burakaydinmu/camur-kabul-bunkeri-on-tasarim/README.md

# Çamur kabul bunkeri — ön tasarım

Baretli Kafa YouTube kanalının "AutoCAD ve Yapay Zeka" bölümünde, Claude'un açık AutoCAD'e bağlanarak hazırladığı örnek ön tasarım: 20 m³'lük yer altı çamur kabul bunkeri, şaftsız helezon konveyörler, deşarj çukuru ve DN50 PN16 flanşlı basma hattı, iki kanatlı sürgülü kapak.

**Ön tasarımdır; imalata ve uygulamaya esas değildir.** Statik, elektrik ve iş güvenliği projeleri ayrıca hazırlanmalıdır.

## Dosyalar
- `bunker.dwg` — AutoCAD çizimi: 6 A1 pafta ve 3B katı model
- `paftalar-pdf/` — paftaların PDF çıktıları (CD-BNK-01 … 06)
- `Montaj-Kilavuzu.pdf` — malzeme listesi ve adım adım montaj kılavuzu (kaynaklar son sayfada)
- `bunker_3B_*.png` — 3B görüntüler (06 no.lu paftada çizime bağlıdır, `bunker.dwg` ile aynı klasörde durmalıdır)
