burakaydinmu/camur-kabul-bunkeri-on-tasarim/paftalar-pdf/CD-BNK-06_Malzeme-listesi-ve-3B.pdf

Firma / yasal sahip BARETLİ KAFA | Proje CLAUDE DENEMESİ Çamur kabul bunkeri — ön tasarım
Çizen Claude | Çizim adı MALZEME LİSTESİ VE 3B GÖRÜNÜŞ Bütün sistem — malzeme listesi, 3B model görüntüleri
Kontrol | —
Onay — | Belge türü Ön tasarım çizimi | Ölçek — | Boyut A1
Tarih 2026-10-07 | Çizim no CD-BNK-06 | Rev. A | Pafta 6 / 6

# 3B MODEL — güneybatıdan bakış (kapak açık)

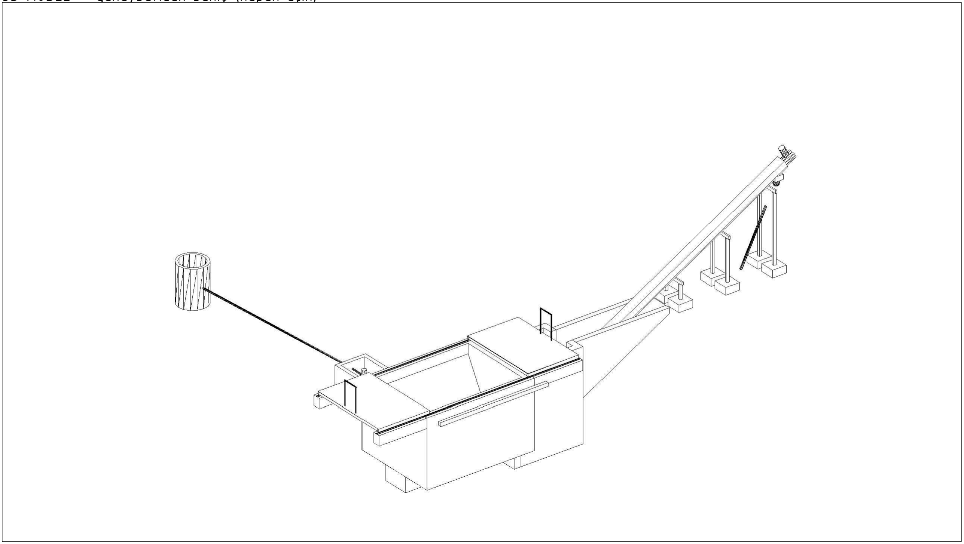
[picture p1: figure]

# 3B MODEL — güneydoğudan bakış (kapak açık)

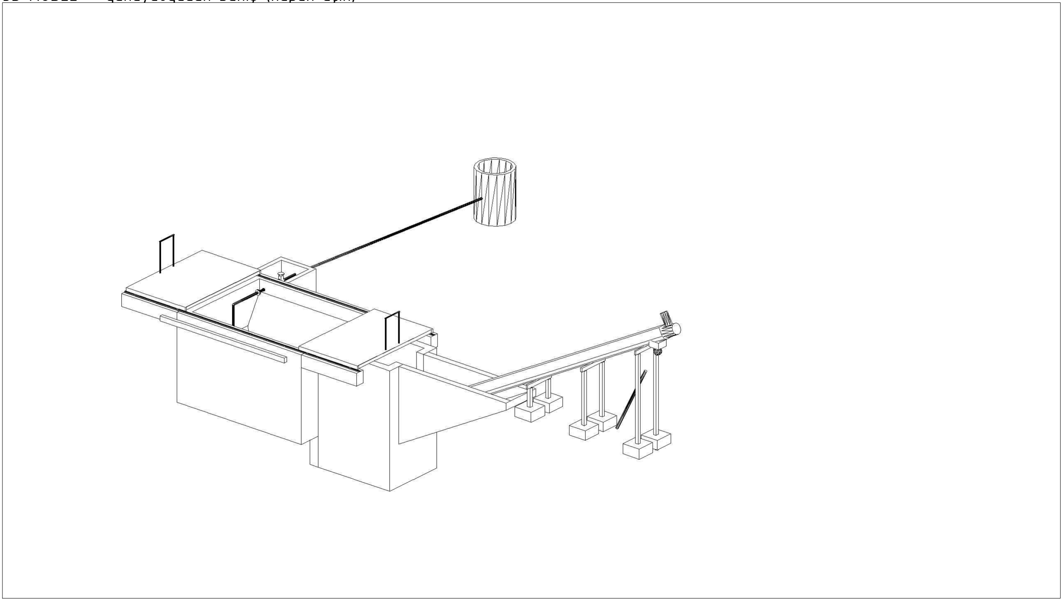
[picture p2: figure]

3B katı model, model uzayında X = 33 600…53 000, Y = 9 000…24 500 bölgesindedir (orijin: 40 000, 12 000; Z = kot). Katmanlar: CL-3D-BETON (mevcut), CL-3D-BETON-EK (öneri), CL-3D-KONVEYOR, CL-3D-CELIK, CL-3D-BORU, CL-3D-KAPAK. Görüntüler gizli çizgili çizdirmedir; modelde spiral, cıvata ve küçük parçalar gösterilmemiştir.

## MALZEME LİSTESİ — BÜTÜN SİSTEM

No | Tanım | Özellik / standart | Miktar | Pafta
A | KONVEYÖR SİSTEMİ
A1 | K1 yatay şaftsız helezon (çıkarıcı) | Ø400, oluk iç 432, L = 4250 (3300 açık + 950 kapalı), 1.4301, UHMW-PE astar 12 mm | 1 takım | 02
A2 | K1 tahrik grubu | Mile geçme redüktörlü motor 2,2 kW + frekans konvertörü + tork kolu (emin değilim) | 1 | 02
A3 | K2 eğimli şaftsız helezon | Ø355, oluk iç 381, L = 13 536, eğim 28,9°, 1.4301, astar 12 mm, cıvatalı kapak | 1 takım | 02
A4 | K2 tahrik grubu | Redüktörlü motor 4,0 kW (çekme tipi) + frekans konvertörü (emin değilim) | 1 | 02
A5 | K1 çıkış / K2 giriş ağzı | 400×400, flanşlı, contalı, 1.4301 | 1 | 02
A6 | K2 döküş ağzı | 350×350, flanş kotu +3,00 | 1 | 02
A7 | K2 destek ayağı (yer üstü) | 2 × SHS 100×100×4 + UPN 120 + L 50×50×5; taban plakası 250×250×12, 4×M16 | 3 | 02
A8 | K2 ayağı / sehpa (çukur ve kanal içi) | Çelik sehpa, dübelli | 3 | 02
A9 | K1 duvar konsolu | Çelik konsol + dübel | 1 | 02
A10 | Çukur ve kanal kapakları | Baklavalı sac 5/7, sökülebilir; 700×700 erişim kapağı + merdiven | 1 takım | 02
A11 | Acil durdurma, dönüş bekçisi, pano | EN 618; kapsam dışı — ayrıca projelendirilecek | 1 takım | —
B | DEŞARJ ÇUKURU VE BASMA HATTI
B1 | Dalgıç pompa | Grundfos Unilift AP35B.50.08.A1V, Rp 2, 1×230 V, 0,71 kW (P2) | 1 | 03
B2 | Dişli flanş + nipel | DN50 PN16, EN 1092-1 Tip 13, 1.4301 | 1 | 03
B3–B5, B8 | Boru makaraları S1–S4 + gömülü boru | Ø60,3×2,0, 1.4301, EN 10217-7; toplam ≈ 13 m; 1 dirsek 90° r = 76 | 4 parça | 03
B6 | Toplu çekvalf | DN50, L = 200, EN 12050-4 (AVK 53/35) | 1 | 03
B7 | Sürgülü vana | DN50 PN10/16, L = 150, EN 1074-2 (AVK 06/80) | 1 | 03
B9 | Flanş | EN 1092-1 Tip 01, DN50 PN16, 1.4301 | 7 | 03
B10 / B11 | Conta / cıvata takımı | EN 1514-1 IBC 61×107×2 / M16×65 A2-70 + somun + 2 pul | 6 / 24 | 03
B12 / B13 | Duvar geçiş contası / boru kelepçesi | Hauff HSD100 (karot Ø100) / DN50 mesafeli, A2 | 3 / 3 | 03
B14 | Deflektör sacı + boru yakası | 1.4301, t = 5, yamuk 600/1975 × 1400, alt 150 mm delikli | 1 | 03
B15 | Vana odası kapağı | Baklavalı sac 5/7, 2 parça, köşebent çerçeve | 1 | 03
C | SÜRGÜLÜ KAPAK
C1 | Kanat 1 (komple) | 2170 × 3360; RHS 120×60×4 + RHS 100×50×3 + sac 4/6; galvanizli; ≈ 490 kg | 1 | 05
C2 | Kanat 2 (komple) | Kanat 1 ile ayna simetrik, bini laması yok; ≈ 480 kg | 1 | 05
C3 | Ray | Mil Ø20 + lama 80×10, S235JR, galvanizli, L = 8700 | 2 | 04
C4 | Tekerlek | Ø140 × 32, yuvarlak oluklu, 2 rulmanlı, 550 kg/teker (IBFM 363 veya eşdeğeri) | 8 | 04
C5 | Ray durdurucusu | Plaka 100×60×10 + lastik tampon | 4 | 04
C6 | Germe mandalı / kilitleme sürgüsü | A2 / Ø16 (ürün seçimi imalatçıda — emin değilim) | 4 / 4 | 04
C7 | Ankraj | M12×110, a = 400, şaşırtmalı | 44 | 04
C8 | Sac cıvatası + perçin somunu | M8×25 havşa başlı, A2 | 176 | 05
D | İNŞAAT İŞLERİ — ÖNERİ (statik proje gerekir)
D1 | Aktarma çukuru | İç 2400 × 1600, taban −3,45, duvar 250, döşeme 300 | 1 | 01, 02
D2 | Konveyör kanalı | Net genişlik 900, yatay boy 4240, duvar 200 | 1 | 01, 02
D3 | Deşarj çukuru | İç 600 × 700 × 700, duvar ve taban 250 | 1 | 03
D4 | Vana odası | İç 1000 × 1100 × 700, duvar ve taban 150 | 1 | 03
D5 | Çıkış duvarı geçiş boşluğu | 560 × 560, su tutucu bant + büzülmesiz harç | 1 | 02
D6 | Ray şerit temeli | 300 × 400; batıda 2 × 2050, doğuda 2 × 2050 | 4 | 04
D7 | Destek ayağı temeli | 600 × 600 × 300 | 7 | 02
D8 | Oluk içi eğim betonu (45° pah) | ≈ 0,54 m³, ikinci döküm | 1 | 02
D9 | Karot delik | Ø100 (bunker duvarı, vana odası, rögar) | 3 | 03
D10 | Tekerlek takozu + seyyar korkuluk | Kamyon tarafı / döküm yapılmayan kenarlar (EN ISO 14122-3, h ≥ 1100) | 1 takım | 01
