burakaydinmu/camur-kabul-bunkeri-on-tasarim/bunker_3B_guneybati.png

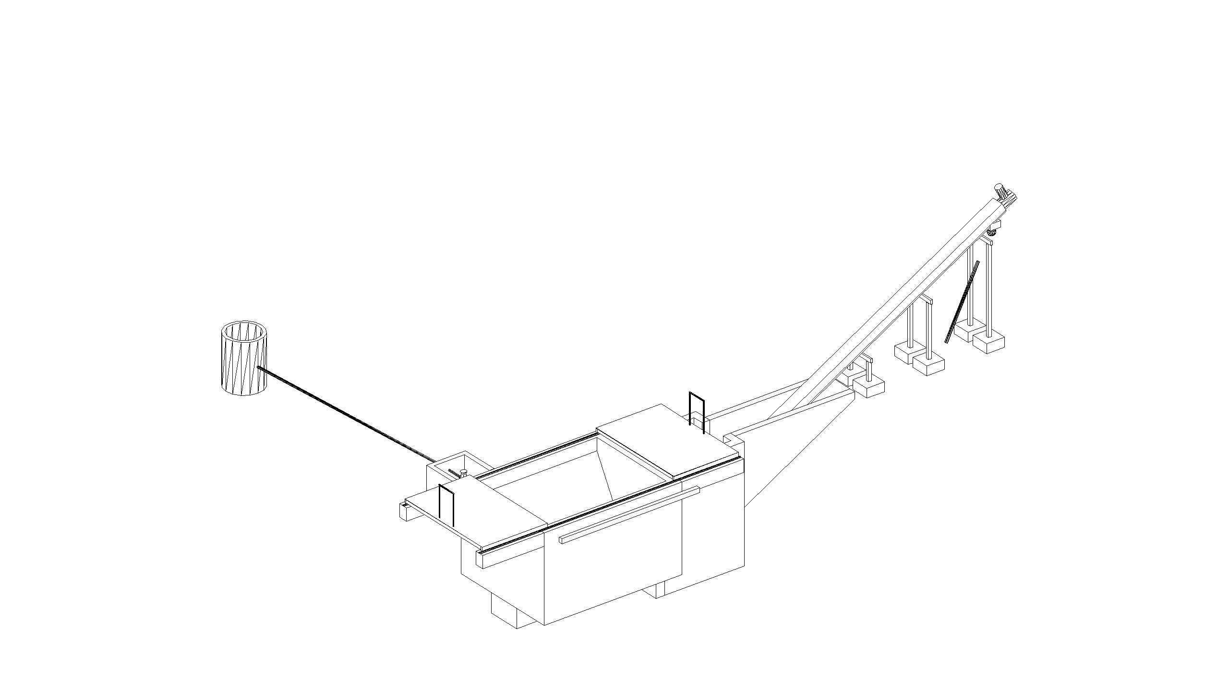
bunker_3B_guneybati.png
