burakaydinmu/camur-kabul-bunkeri-on-tasarim/bunker_3B_guneydogu.png

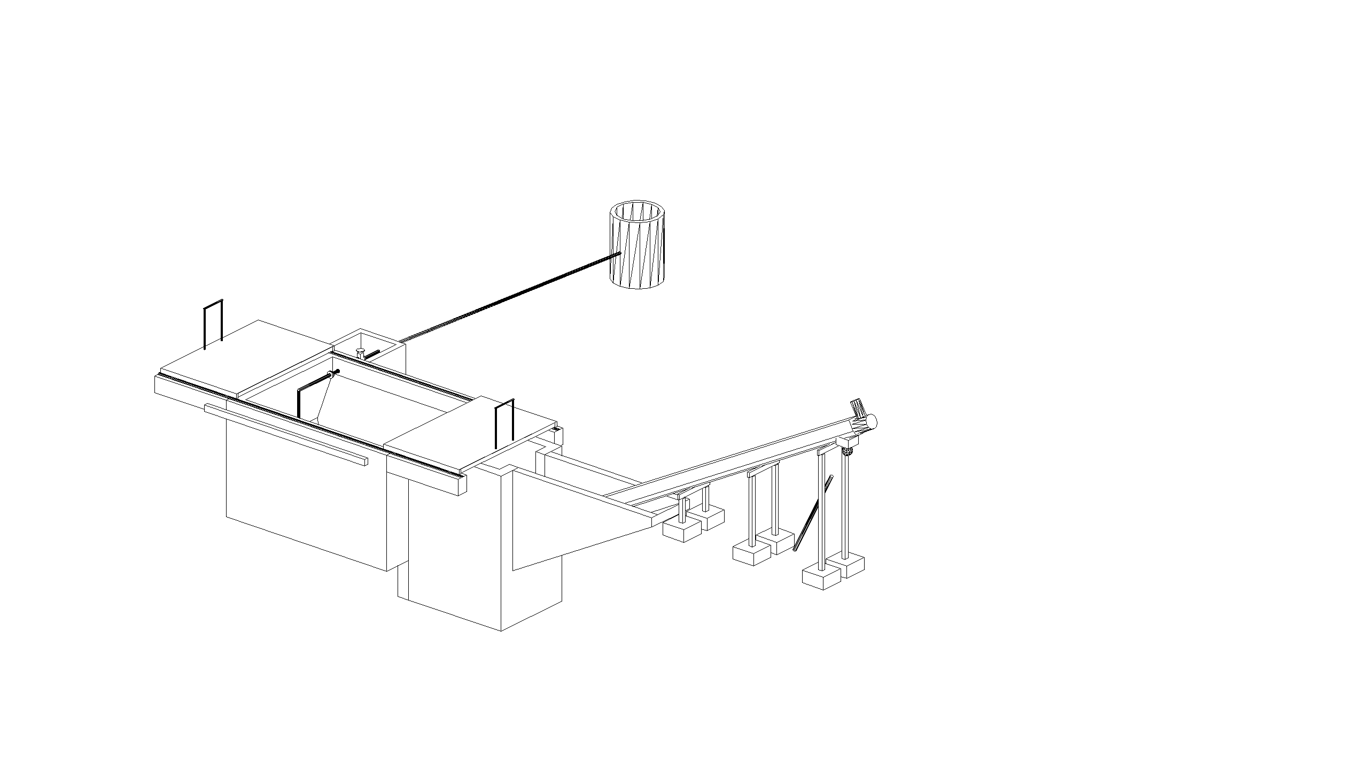
bunker_3B_guneydogu.png
