burakaydinmu/camur-kabul-bunkeri-on-tasarim/(list of files, cad)

Other CAD files:
bunker.dwg
