burakaydinmu/camur-kabul-bunkeri-on-tasarim/paftalar-pdf/CD-BNK-03_Desarj-cukuru-ve-basma-hatti.pdf

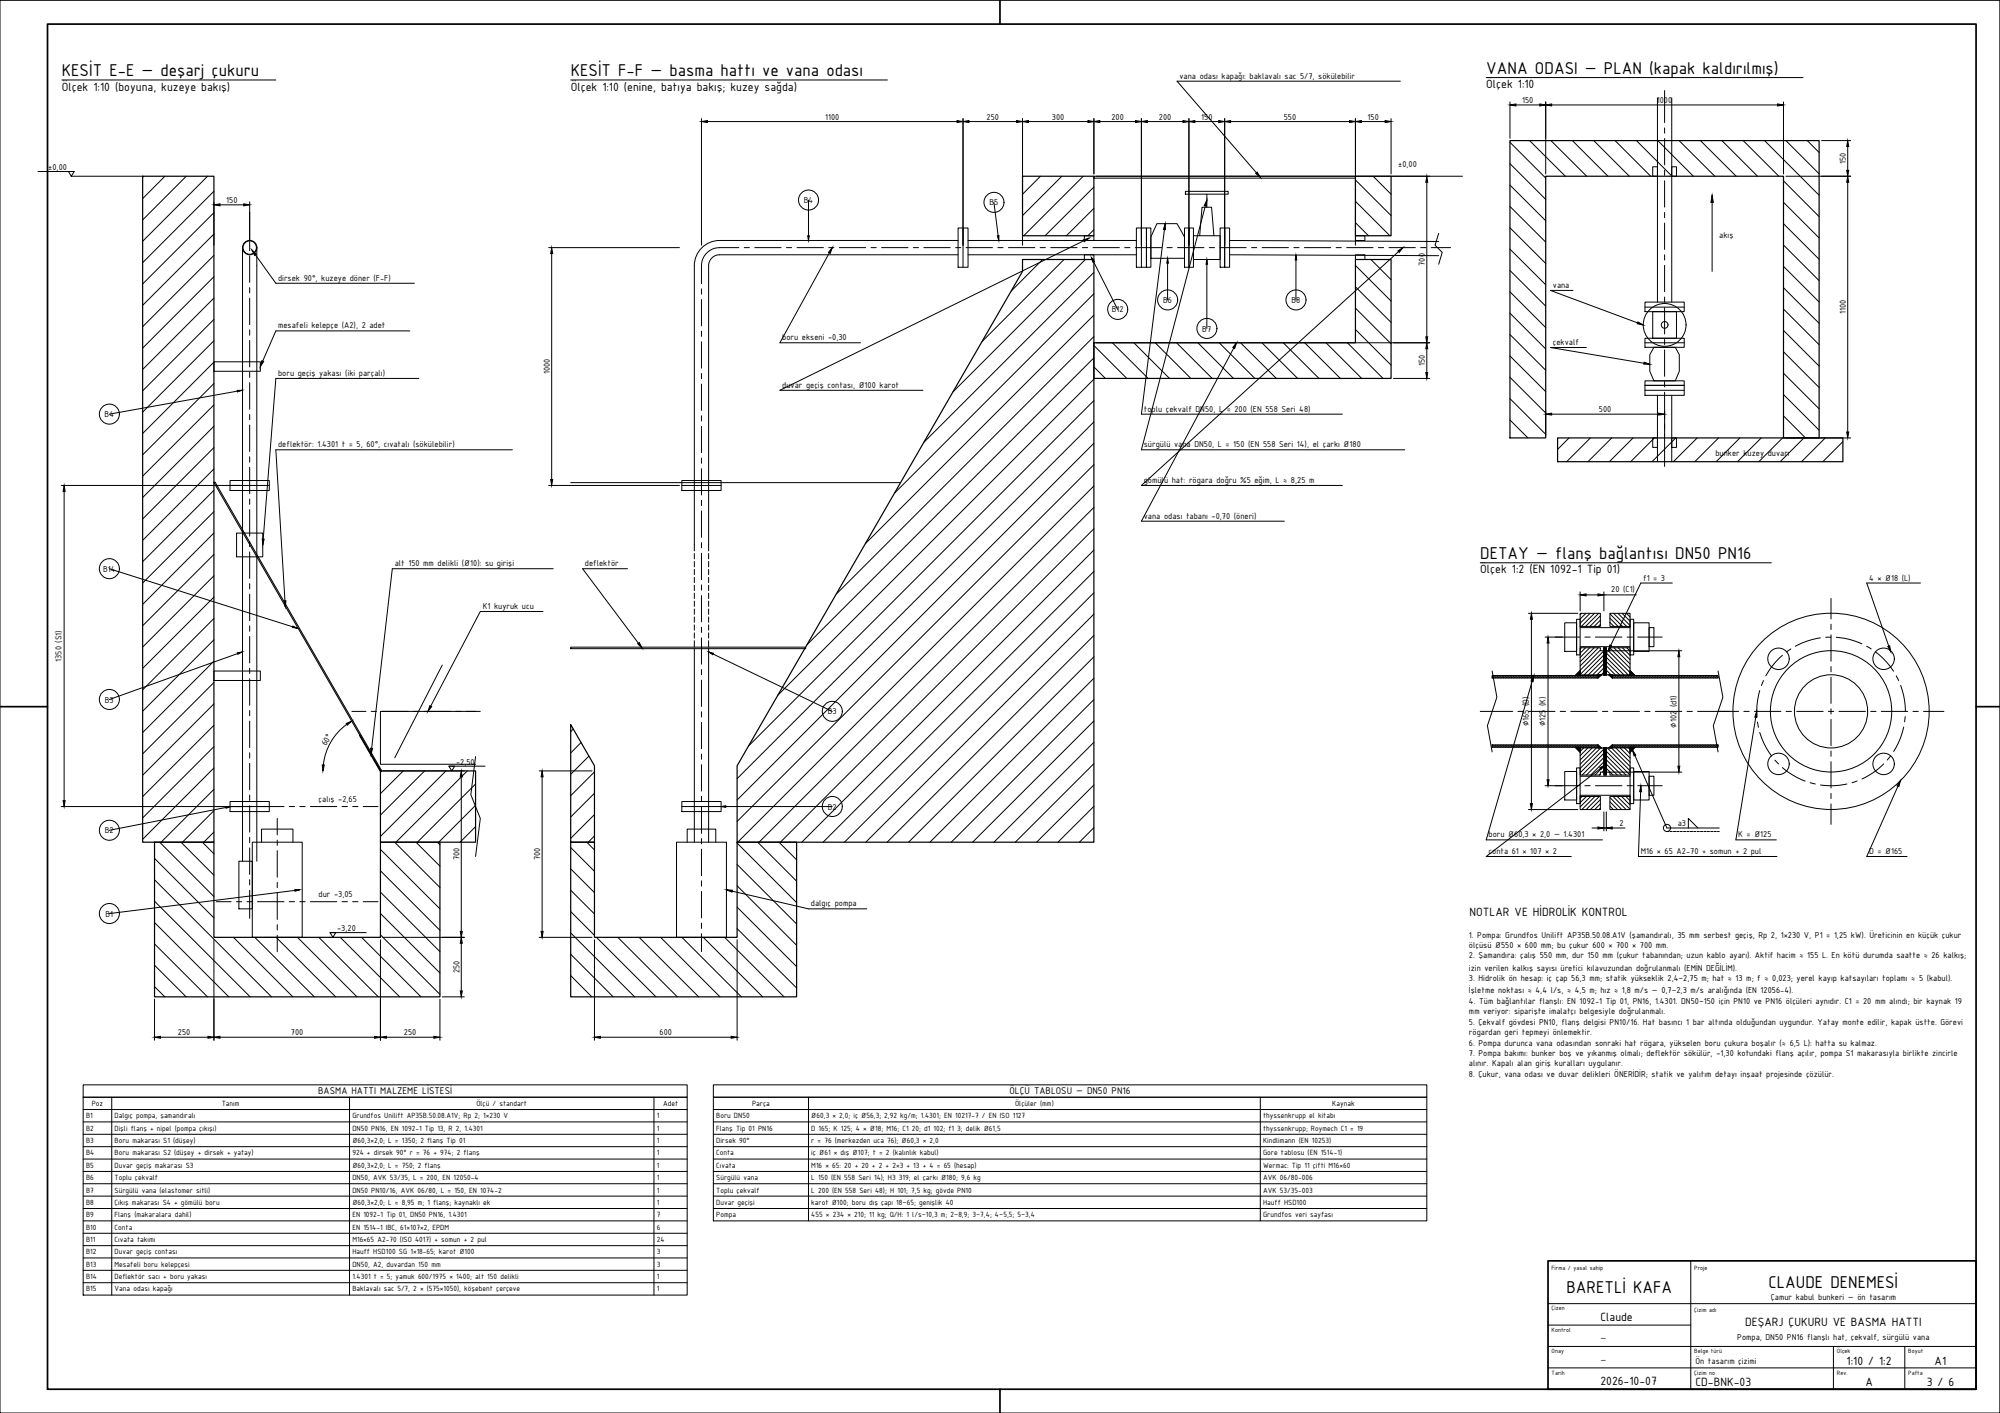
[picture p11: page 1]
çalış −2,65; dur −3,05; K1 kuyruk ucu; boru ekseni −0,30; dalgıç pompa; Ölçek 1:2 (EN 1092-1 Tip 01) ∅165 (D); boru Ø60,3 × 2,0 — 1.4301; conta 61 × 107 × 2; M16 × 65 A2-70 + somun + 2 pul; Poz; Tanım; Ölçü / standart; Adet; Dalgıç pompa, şamandıralı; Grundfos Unilift AP35B.50.08.A1V; Rp 2; 1×230 V; Dişli flanş + nipel (pompa çıkışı); DN50 PN16, EN 1092-1 Tip 13, R 2, 1.4301; Boru makarası S1 (düşey); Ø60,3×2,0; L = 1350; 2 flanş Tip 01; Boru makarası S2 (düşey + dirsek + yatay)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

KESİT E-E — deşarj çukuru
Ölçek 1:10 (boyuna, kuzeye bakış)

KESİT F-F — basma hattı ve vana odası
Ölçek 1:10 (enine, batıya bakış; kuzey sağda)

VANA ODASI — PLAN (kapak kaldırılmış) Ölçek 1:10

vana odası kapağı: baklavalı sac 5/7, sökülebilir

dirsek 90°, kuzeye döner (F-F)

mesafeli kelepçe (A2), 2 adet

boru geçiş yakası (iki parçalı)

duvar geçiş contası, Ø100 karot

toplu çekvalf DN50, L = 200 (EN 558 Seri 48)

deflektör: 1.4301 t = 5, 60°, cıvatalı (sökülebilir)

sürgülü vana DN50, L = 150 (EN 558 Seri 14), el çarkı Ø180

bunker kuzey duvarı

gömülü hat: rögara doğru %5 eğim, L ≈ 8,25 m

vana odası tabanı −0,70 (öneri)

DETAY — flanş bağlantısı DN50 PN16

alt 150 mm delikli (Ø10): su girişi

NOTLAR VE HİDROLİK KONTROL

1. Pompa: Grundfos Unilift AP35B.50.08.A1V (şamandıralı, 35 mm serbest geçiş, Rp 2, 1×230 V, P1 = 1,25 kW). Üreticinin en küçük çukur
ölçüsü Ø550 × 600 mm; bu çukur 600 × 700 × 700 mm.
2. Şamandıra: çalış 550 mm, dur 150 mm (çukur tabanından; uzun kablo ayarı). Aktif hacim ≈ 155 L. En kötü durumda saatte ≈ 26 kalkış;
izin verilen kalkış sayısı üretici kılavuzundan doğrulanmalı (EMİN DEĞİLİM).
3. Hidrolik ön hesap: iç çap 56,3 mm; statik yükseklik 2,4–2,75 m; hat ≈ 13 m; f ≈ 0,023; yerel kayıp katsayıları toplamı ≈ 5 (kabul).
İşletme noktası ≈ 4,4 l/s, ≈ 4,5 m; hız ≈ 1,8 m/s — 0,7–2,3 m/s aralığında (EN 12056-4).
4. Tüm bağlantılar flanşlı: EN 1092-1 Tip 01, PN16, 1.4301. DN50–150 için PN10 ve PN16 ölçüleri aynıdır. C1 = 20 mm alındı; bir kaynak 19
mm veriyor: siparişte imalatçı belgesiyle doğrulanmalı.
5. Çekvalf gövdesi PN10, flanş delgisi PN10/16. Hat basıncı 1 bar altında olduğundan uygundur. Yatay monte edilir, kapak üstte. Görevi
rögardan geri tepmeyi önlemektir.
6. Pompa durunca vana odasından sonraki hat rögara, yükselen boru çukura boşalır (≈ 6,5 L): hatta su kalmaz.
7. Pompa bakımı: bunker boş ve yıkanmış olmalı; deflektör sökülür, −1,30 kotundaki flanş açılır, pompa S1 makarasıyla birlikte zincirle
alınır. Kapalı alan giriş kuralları uygulanır.
8. Çukur, vana odası ve duvar delikleri ÖNERİDİR; statik ve yalıtım detayı inşaat projesinde çözülür.

BASMA HATTI MALZEME LİSTESİ

B10 | Conta | EN 1514-1 IBC, 61×107×2, EPDM | 6
B11 | Cıvata takımı | M16×65 A2-70 (ISO 4017) + somun + 2 pul | 24

B12 | Duvar geçiş contası | Hauff HSD100 SG 1×18-65; karot Ø100 | 3
B13 | Mesafeli boru kelepçesi | DN50, A2, duvardan 150 mm | 3
B14 | Deflektör sacı + boru yakası | 1.4301 t = 5; yamuk 600/1975 × 1400; alt 150 delikli | 1
B15 | Vana odası kapağı | Baklavalı sac 5/7, 2 × (575×1050), köşebent çerçeve | 1

Firma / yasal sahip BARETLİ KAFA | Proje CLAUDE DENEMESİ Çamur kabul bunkeri — ön tasarım

Çizen Claude | Çizim adı DEŞARJ ÇUKURU VE BASMA HATTI Pompa, DN50 PN16 flanşlı hat, çekvalf, sürgülü vana

Onay — | Belge türü Ön tasarım çizimi | Ölçek 1:10 / 1:2 | Boyut A1

Tarih 2026-10-07 | Çizim no CD-BNK-03 | Rev. A | Pafta 3 / 6
