burakaydinmu/camur-kabul-bunkeri-on-tasarim/paftalar-pdf/CD-BNK-04_Kapak-genel.pdf

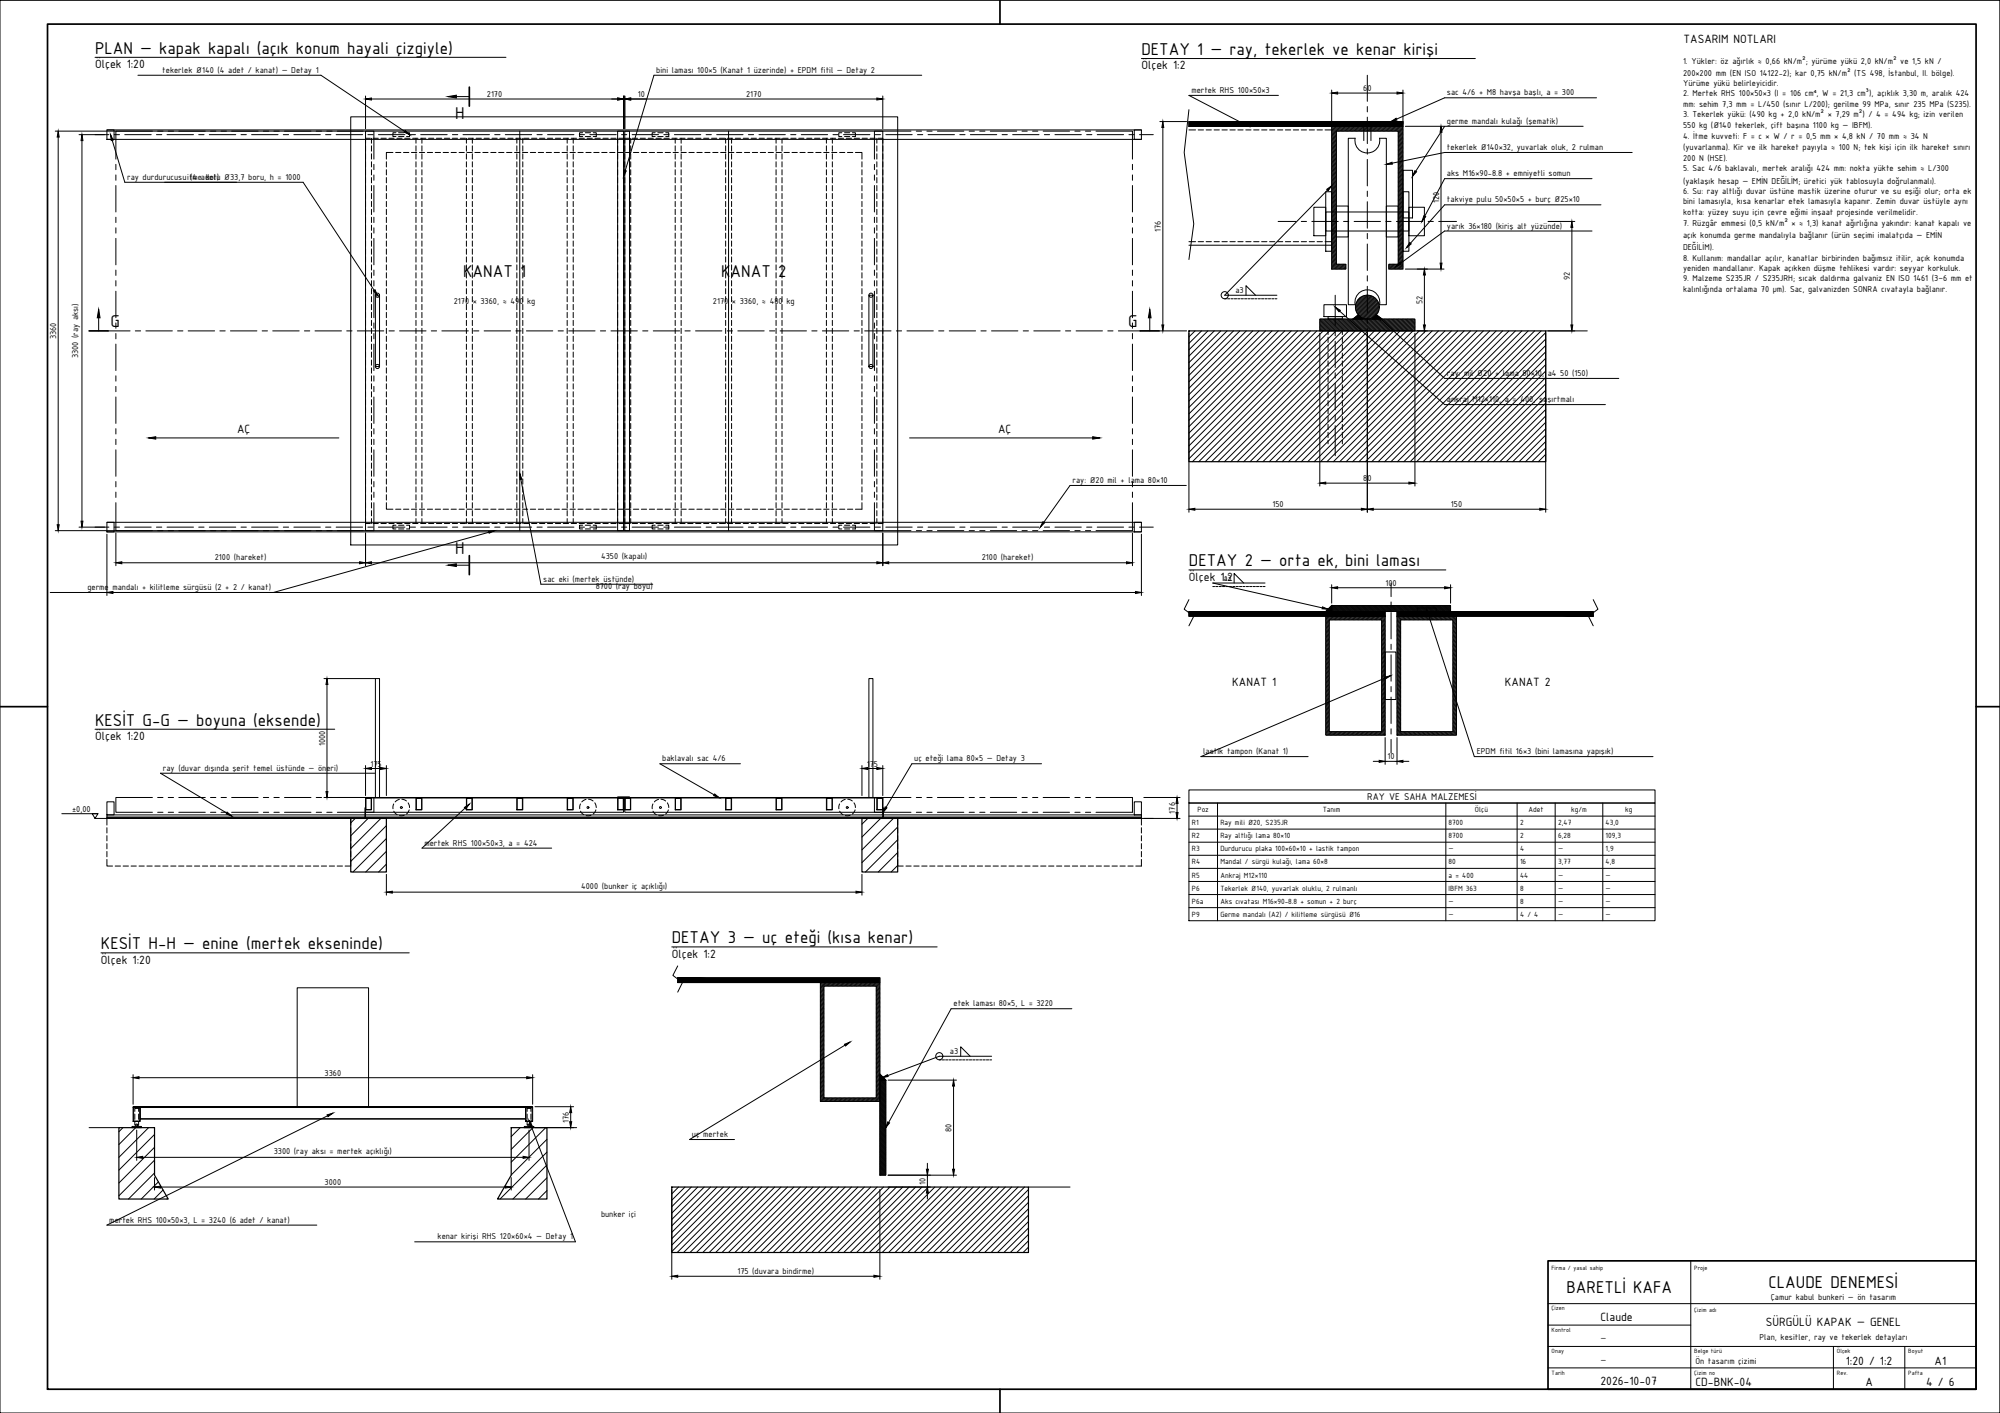
[picture p12: page 1]
2100 (hareket); 4350 (kapalı); 8700 (ray boyu); 3300 (ray aksı) 3360; KESİT G-G — boyuna (eksende) Ölçek 1:20; mertek RHS 100×50×3, a = 424; baklavalı sac 4/6; uç eteği lama 80×5 — Detay 3; ray: mil Ø20 + lama 80×10,; ankraj M12×110, a = 400, şaşırtmalı; mertek RHS 100×50×3; KANAT 1; KANAT 2; lastik tampon (Kanat 1); EPDM fitil 16×3 (bini lamasına yapışık); 175 (duvara bindirme); bunker içi; etek laması 80×5, L = 3220; uç mertek; TASARIM NOTLARI

PLAN — kapak kapalı (açık konum hayali çizgiyle) Ölçek 1:20

DETAY 1 — ray, tekerlek ve kenar kirişi Ölçek 1:2

1. Yükler: öz ağırlık ≈ 0,66 kN/m²; yürüme yükü 2,0 kN/m² ve 1,5 kN /
200×200 mm (EN ISO 14122-2); kar 0,75 kN/m² (TS 498, İstanbul, II. bölge).
Yürüme yükü belirleyicidir.
2. Mertek RHS 100×50×3 (I = 106 cm⁴, W = 21,3 cm³), açıklık 3,30 m, aralık 424
mm: sehim 7,3 mm = L/450 (sınır L/200); gerilme 99 MPa, sınır 235 MPa (S235).
3. Tekerlek yükü: (490 kg + 2,0 kN/m² × 7,29 m²) / 4 = 494 kg; izin verilen
550 kg (Ø140 tekerlek, çift başına 1100 kg — IBFM).
4. İtme kuvveti: F = c × W / r = 0,5 mm × 4,8 kN / 70 mm ≈ 34 N
(yuvarlanma). Kir ve ilk hareket payıyla ≈ 100 N; tek kişi için ilk hareket sınırı
200 N (HSE).
5. Sac 4/6 baklavalı, mertek aralığı 424 mm: nokta yükte sehim ≈ L/300
(yaklaşık hesap — EMİN DEĞİLİM; üretici yük tablosuyla doğrulanmalı).
6. Su: ray altlığı duvar üstüne mastik üzerine oturur ve su eşiği olur; orta ek
bini lamasıyla, kısa kenarlar etek lamasıyla kapanır. Zemin duvar üstüyle aynı
kotta: yüzey suyu için çevre eğimi inşaat projesinde verilmelidir.
7. Rüzgâr emmesi (0,5 kN/m² × ≈ 1,3) kanat ağırlığına yakındır: kanat kapalı ve
açık konumda germe mandalıyla bağlanır (ürün seçimi imalatçıda — EMİN
DEĞİLİM).
8. Kullanım: mandallar açılır, kanatlar birbirinden bağımsız itilir, açık konumda
yeniden mandallanır. Kapak açıkken düşme tehlikesi vardır: seyyar korkuluk.
9. Malzeme S235JR / S235JRH; sıcak daldırma galvaniz EN ISO 1461 (3–6 mm et
kalınlığında ortalama 70 µm). Sac, galvanizden SONRA cıvatayla bağlanır.

tekerlek Ø140 (4 adet / kanat) — Detay 1

bini laması 100×5 (Kanat 1 üzerinde) + EPDM fitil — Detay 2

sac 4/6 + M8 havşa başlı, a = 300

germe mandalı kulağı (şematik)

tekerlek Ø140×32, yuvarlak oluk, 2 rulman

aks M16×90-8.8 + emniyetli somun

ray durdurucusu (4 adet)

itme kolu Ø33,7 boru, h = 1000

takviye pulu 50×50×5 + burç Ø25×10

yarık 36×180 (kiriş alt yüzünde)

ray: Ø20 mil + lama 80×10

DETAY 2 — orta ek, bini laması
Ölçek 1:2

sac eki (mertek üstünde)

germe mandalı + kilitleme sürgüsü (2 + 2 / kanat)

ray (duvar dışında şerit temel üstünde — öneri)

RAY VE SAHA MALZEMESİ

Poz | Tanım | Ölçü | Adet | kg/m | kg

R1 | Ray mili Ø20, S235JR | 8700 | 2 | 2,47 | 43,0
R2 | Ray altlığı lama 80×10 | 8700 | 2 | 6,28 | 109,3

R3 | Durdurucu plaka 100×60×10 + lastik tampon | — | 4 | — | 1,9
R4 | Mandal / sürgü kulağı, lama 60×8 | 80 | 16 | 3,77 | 4,8

R5 | Ankraj M12×110 | a = 400 | 44 | — | —

4000 (bunker iç açıklığı)

P6 | Tekerlek Ø140, yuvarlak oluklu, 2 rulmanlı | IBFM 363 | 8 | — | —

P6a | Aks cıvatası M16×90-8.8 + somun + 2 burç | — | 8 | — | —
P9 | Germe mandalı (A2) / kilitleme sürgüsü Ø16 | — | 4 / 4 | — | —

DETAY 3 — uç eteği (kısa kenar) Ölçek 1:2

KESİT H-H — enine (mertek ekseninde)
Ölçek 1:20

3300 (ray aksı = mertek açıklığı)

mertek RHS 100×50×3, L = 3240 (6 adet / kanat)

kenar kirişi RHS 120×60×4 — Detay 1

Firma / yasal sahip BARETLİ KAFA | Proje CLAUDE DENEMESİ Çamur kabul bunkeri — ön tasarım

Çizen Claude | Çizim adı SÜRGÜLÜ KAPAK — GENEL Plan, kesitler, ray ve tekerlek detayları

Onay — | Belge türü Ön tasarım çizimi | Ölçek 1:20 / 1:2 | Boyut A1

Tarih 2026-10-07 | Çizim no CD-BNK-04 | Rev. A | Pafta 4 / 6
