burakaydinmu/camur-kabul-bunkeri-on-tasarim/paftalar-pdf/CD-BNK-01_Genel-yerlesim.pdf

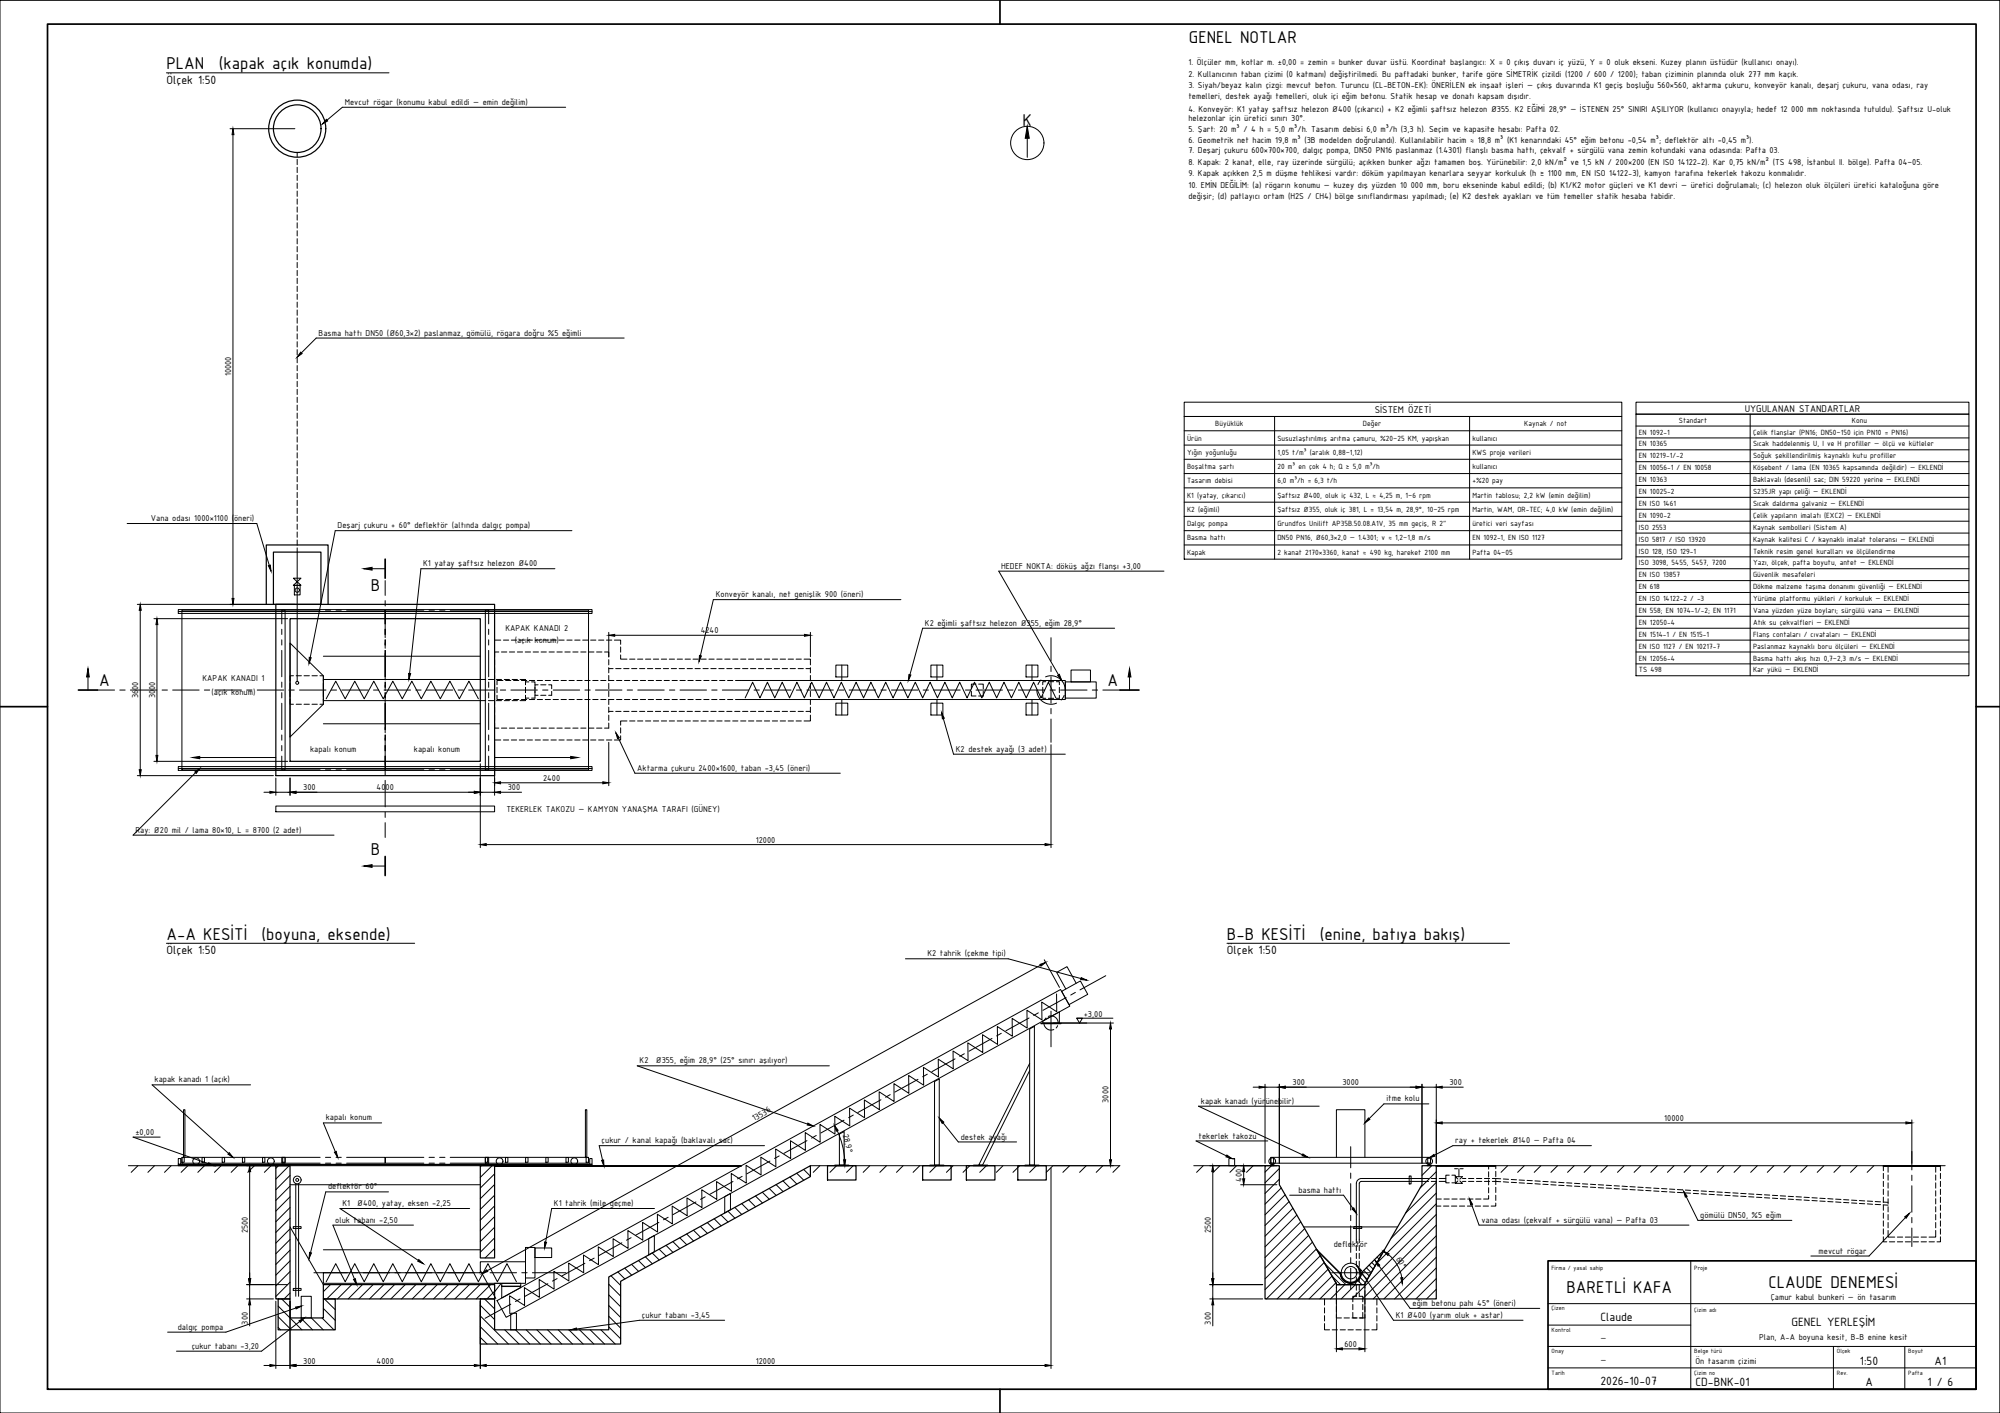
[picture p14: page 1]
kapalı konum; oluk tabanı −2,50; çukur tabanı −3,20; çukur tabanı −3,45; K1 Ø400, yatay, eksen −2,25; deflektör 60°; dalgıç pompa; destek ayağı; basma hattı; itme kolu; gömülü DN50, %5 eğim; mevcut rögar; tekerlek takozu; GENEL NOTLAR; SİSTEM ÖZETİ; Büyüklük; Değer; Kaynak / not; Tasarım debisi; +%20 pay; K1 (yatay, çıkarıcı); Şaftsız Ø400, oluk iç 432, L ≈ 4,25 m, 1–6 rpm; Martin tablosu; 2,2 kW (emin değilim); Kapak; 2 kanat 2170×3360, kanat ≈ 490 kg, hareket 2100 mm; Pafta 04–05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

PLAN (kapak açık konumda) Ölçek 1:50

1. Ölçüler mm, kotlar m. ±0,00 = zemin = bunker duvar üstü. Koordinat başlangıcı: X = 0 çıkış duvarı iç yüzü, Y = 0 oluk ekseni. Kuzey planın üstüdür (kullanıcı onayı).
2. Kullanıcının taban çizimi (0 katmanı) değiştirilmedi. Bu paftadaki bunker, tarife göre SİMETRİK çizildi (1200 / 600 / 1200); taban çiziminin planında oluk 277 mm kaçık.
3. Siyah/beyaz kalın çizgi: mevcut beton. Turuncu (CL-BETON-EK): ÖNERİLEN ek inşaat işleri — çıkış duvarında K1 geçiş boşluğu 560×560, aktarma çukuru, konveyör kanalı, deşarj çukuru, vana odası, ray
temelleri, destek ayağı temelleri, oluk içi eğim betonu. Statik hesap ve donatı kapsam dışıdır.
4. Konveyör: K1 yatay şaftsız helezon Ø400 (çıkarıcı) + K2 eğimli şaftsız helezon Ø355. K2 EĞİMİ 28,9° — İSTENEN 25° SINIRI AŞILIYOR (kullanıcı onayıyla; hedef 12 000 mm noktasında tutuldu). Şaftsız U-oluk
helezonlar için üretici sınırı 30°.
5. Şart: 20 m³ / 4 h = 5,0 m³/h. Tasarım debisi 6,0 m³/h (3,3 h). Seçim ve kapasite hesabı: Pafta 02.
6. Geometrik net hacim 19,8 m³ (3B modelden doğrulandı). Kullanılabilir hacim ≈ 18,8 m³ (K1 kenarındaki 45° eğim betonu −0,54 m³; deflektör altı −0,45 m³).
7. Deşarj çukuru 600×700×700, dalgıç pompa, DN50 PN16 paslanmaz (1.4301) flanşlı basma hattı, çekvalf + sürgülü vana zemin kotundaki vana odasında: Pafta 03.
8. Kapak: 2 kanat, elle, ray üzerinde sürgülü; açıkken bunker ağzı tamamen boş. Yürünebilir: 2,0 kN/m² ve 1,5 kN / 200×200 (EN ISO 14122-2). Kar 0,75 kN/m² (TS 498, İstanbul II. bölge). Pafta 04–05.
9. Kapak açıkken 2,5 m düşme tehlikesi vardır: döküm yapılmayan kenarlara seyyar korkuluk (h ≥ 1100 mm, EN ISO 14122-3), kamyon tarafına tekerlek takozu konmalıdır.
10. EMİN DEĞİLİM: (a) rögarın konumu — kuzey dış yüzden 10 000 mm, boru ekseninde kabul edildi; (b) K1/K2 motor güçleri ve K1 devri — üretici doğrulamalı; (c) helezon oluk ölçüleri üretici kataloğuna göre
değişir; (d) patlayıcı ortam (H2S / CH4) bölge sınıflandırması yapılmadı; (e) K2 destek ayakları ve tüm temeller statik hesaba tabidir.

Mevcut rögar (konumu kabul edildi — emin değilim)

Basma hattı DN50 (Ø60,3×2) paslanmaz, gömülü, rögara doğru %5 eğimli

EN 1092-1 | Çelik flanşlar (PN16; DN50–150 için PN10 = PN16)
EN 10365 | Sıcak haddelenmiş U, I ve H profiller — ölçü ve kütleler
EN 10219-1/-2 | Soğuk şekillendirilmiş kaynaklı kutu profiller
EN 10056-1 / EN 10058 | Köşebent / lama (EN 10365 kapsamında değildir) — EKLENDİ

Ürün | Susuzlaştırılmış arıtma çamuru, %20–25 KM, yapışkan | kullanıcı

Yığın yoğunluğu | 1,05 t/m³ (aralık 0,88–1,12) | KWS proje verileri

Boşaltma şartı | 20 m³ en çok 4 h; Q ≥ 5,0 m³/h | kullanıcı

EN ISO 1461 | Sıcak daldırma galvaniz — EKLENDİ
EN 1090-2 | Çelik yapıların imalatı (EXC2) — EKLENDİ

K2 (eğimli) | Şaftsız Ø355, oluk iç 381, L = 13,54 m, 28,9°, 10–25 rpm | Martin, WAM, OR-TEC; 4,0 kW (emin değilim)

Deşarj çukuru + 60° deflektör (altında dalgıç pompa) Vana odası 1000×1100 (öneri)

Dalgıç pompa | Grundfos Unilift AP35B.50.08.A1V, 35 mm geçiş, R 2" | üretici veri sayfası

ISO 2553 | Kaynak sembolleri (Sistem A)
ISO 5817 / ISO 13920 | Kaynak kalitesi C / kaynaklı imalat toleransı — EKLENDİ

Basma hattı | DN50 PN16, Ø60,3×2,0 — 1.4301; v ≈ 1,2–1,8 m/s | EN 1092-1, EN ISO 1127

K1 yatay şaftsız helezon Ø400

ISO 3098, 5455, 5457, 7200 | Yazı, ölçek, pafta boyutu, antet — EKLENDİ

HEDEF NOKTA: döküş ağzı flanşı +3,00

EN ISO 13857 | Güvenlik mesafeleri
EN 618 | Dökme malzeme taşıma donanımı güvenliği — EKLENDİ
EN ISO 14122-2 / -3 | Yürüme platformu yükleri / korkuluk — EKLENDİ
EN 558; EN 1074-1/-2; EN 1171 | Vana yüzden yüze boyları; sürgülü vana — EKLENDİ
EN 12050-4 | Atık su çekvalfleri — EKLENDİ
EN 1514-1 / EN 1515-1 | Flanş contaları / cıvataları — EKLENDİ
EN ISO 1127 / EN 10217-7 | Paslanmaz kaynaklı boru ölçüleri — EKLENDİ
EN 12056-4 | Basma hattı akış hızı 0,7–2,3 m/s — EKLENDİ
TS 498 | Kar yükü — EKLENDİ

Konveyör kanalı, net genişlik 900 (öneri)

K2 eğimli şaftsız helezon Ø355, eğim 28,9°

KAPAK KANADI 1 (açık konum) | KAPAK KANADI 2 (açık konum)

K2 destek ayağı (3 adet)

Aktarma çukuru 2400×1600, taban −3,45 (öneri)

TEKERLEK TAKOZU — KAMYON YANAŞMA TARAFI (GÜNEY)

Ray: Ø20 mil / lama 80×10, L = 8700 (2 adet)

A-A KESİTİ (boyuna, eksende) Ölçek 1:50

B-B KESİTİ (enine, batıya bakış) Ölçek 1:50

K2 tahrik (çekme tipi)

K2 Ø355, eğim 28,9° (25° sınırı aşılıyor)

kapak kanadı 1 (açık)

kapak kanadı (yürünebilir)

çukur / kanal kapağı (baklavalı sac)

ray + tekerlek Ø140 — Pafta 04

K1 tahrik (mile geçme)

vana odası (çekvalf + sürgülü vana) — Pafta 03

Firma / yasal sahip BARETLİ KAFA | Proje CLAUDE DENEMESİ Çamur kabul bunkeri — ön tasarım

eğim betonu pahı 45° (öneri)
K1 Ø400 (yarım oluk + astar)

Çizen Claude | Çizim adı GENEL YERLEŞİM Plan, A-A boyuna kesit, B-B enine kesit

Onay — | Belge türü Ön tasarım çizimi | Ölçek 1:50 | Boyut A1

Tarih 2026-10-07 | Çizim no CD-BNK-01 | Rev. A | Pafta 1 / 6
